YurenSUN/Ankle-Protector/README.md

# Ankle-Protector
Ankle-Protector App work with Arduino Nano 33 BLE

A technology-enhanced ankle brace that uses sensors to track harmful movements and alerts the wearer to avoid further injury from mild sprain

## Contents

- updates and processes -  [project-process.md](project-process.md)

- description - [final-description.md](./final-description.md)

- Codes
  - Arduino codes for microcontroller - ankle-protector-arduino folder
  - IOS App - ankle-proctor-swift
- Poster - smart-ankle-sensor-poster (.ai, .pdf), poster-text.md
- imgs - images used in updates 

## Material list

| **Material** | **Quantity** | **Price** | **Link** | |
| --- | --- | --- | --- | ---- |
| Arduino Nano 33 BLE | 1 | $23 + $1.27 tax when I purchased | [Amazon](https://www.amazon.com/gp/product/B07WV59YTZ/ref=ppx_yo_dt_b_asin_title_o00_s00?ie=UTF8&psc=1) | |
| Hook part of hook and loop tapes  | N/A | $0, got them from the class | N/A | |
| Flex sensors | 2 | $11.28 total - $0 for one from class. Another for $11.28 after tax from Amazon. | [Amazon](https://www.amazon.com/gp/product/B07MHTWR1C/ref=ppx_od_dt_b_asin_title_s00?ie=UTF8&psc=1) | |
| force-sensitive resistor - Normal | 2 | $12.77 total - $0 for one from class. $12.77 after tax (purchased on Amazon as there is no delivery fee). | [Amazon](https://www.amazon.com/gp/product/B00B887CLS/ref=ppx_yo_dt_b_asin_title_o00_s00?ie=UTF8&psc=1) | |
| Resistors | 4 | $0, got them from class | N/A | |
| Normal and Conductive threads | N/A | $0, got it from class and have normal threads at home | N/A | |
| Textiles | N/A | $0, will get them from class | N/A | |
| JST Female End | 1 | $7.37 after taxes. Not sure whether this would work. I Will return and find a new one if this does not work | [Amazon](https://www.amazon.com/gp/product/B07NWNPB77/ref=ppx_yo_dt_b_asin_title_o01_s00?ie=UTF8&psc=1) | |
| | | | | |
