YurenSUN/Ankle-Protector/smart-ankle-sensor-poster.pdf

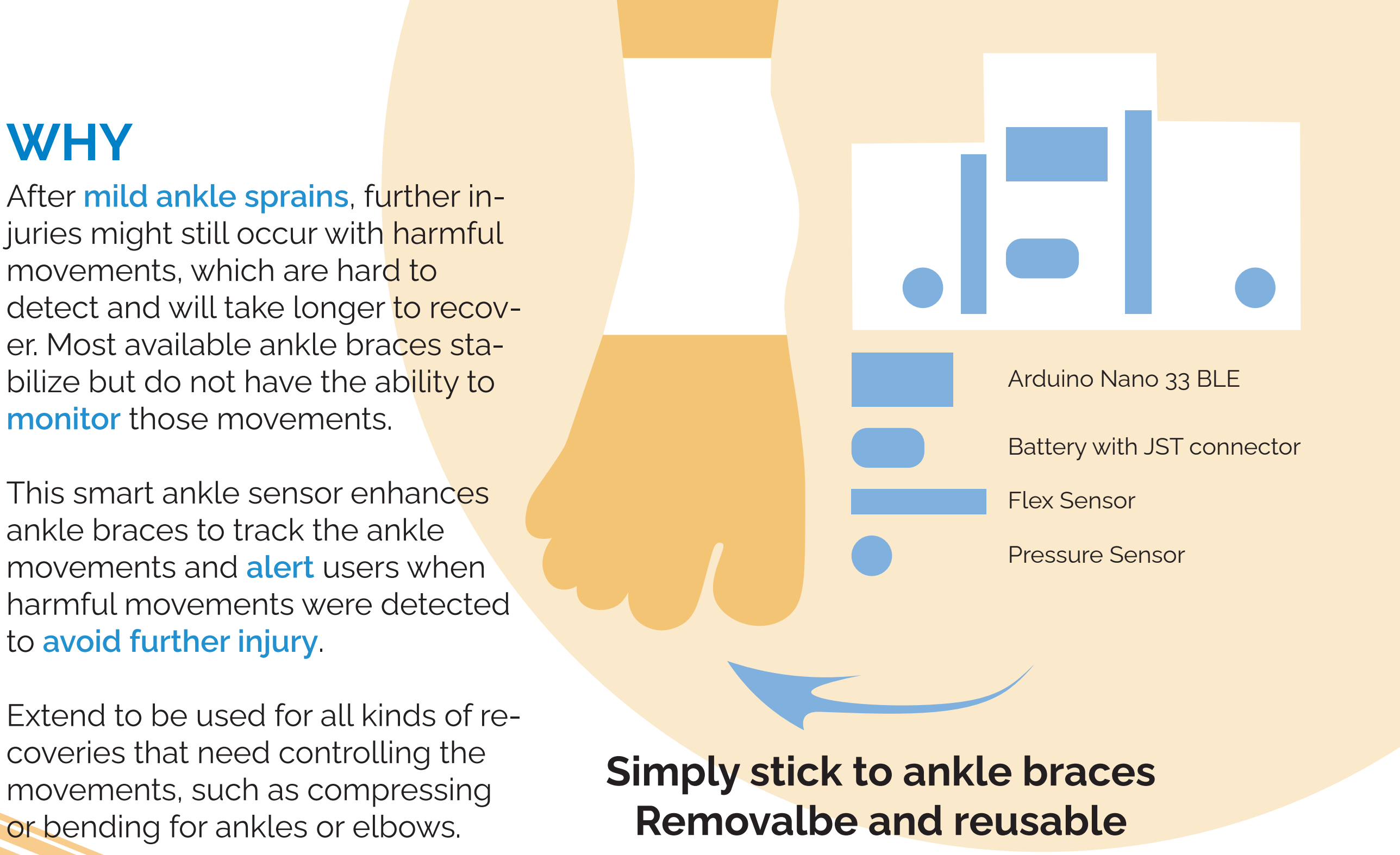
[picture p10: figure]
Arduino Nano 33 BLE; Battery with JST connector; Flex Sensor; Pressure Sensor; After mild ankle sprains, further in- juries might still occur with harmful movements, which are hard to detect and will take longer to recov- er. Most available ankle braces sta- bilize but do not have the ability to monitor those movements.; This smart ankle sensor enhances ankle braces to track the ankle movements and alert users when harmful movements were detected to avoid further injury.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

# SMART ANKLE SENSOR

## A technology enhancing ankle braces that uses sensors to track harmful movements and alerts the wearer to avoid further injury from mild sprain

## Yuren Sun

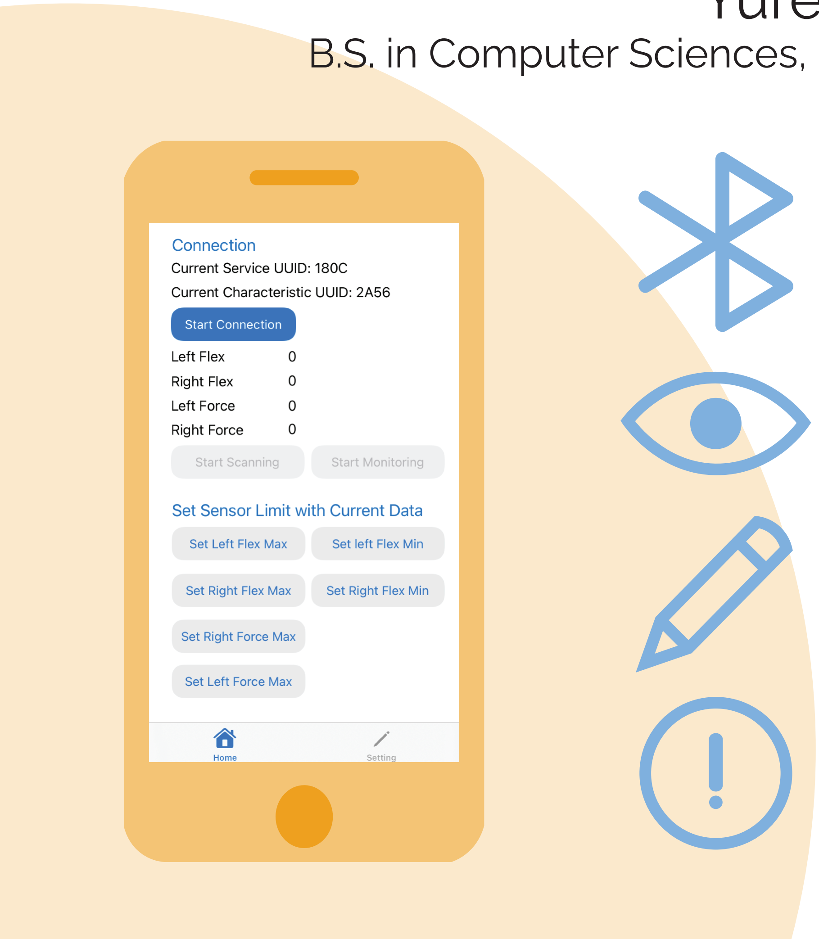
[picture p11: figure]

B.S. in Computer Sciences, Economics, and Mathematics

## One-click connect through Bluetooth

## Monitor ankle movements with sensor data

## Send alerts when harmful movements are detected

## Customize thresholds for detection and alert
