YurenSUN/Ankle-Protector/(commit log)

2021-11-14 Update on RN and arduino
2021-11-14 update with arduino to add another pin and rn app
2021-11-24 update arduino
2021-12-12 finish the project, might have minor typo fixing later
    [ankle-protector-arduino.ino]
